Haddley/bikespeed/rearlight/fuse_block_side_exit.3mf

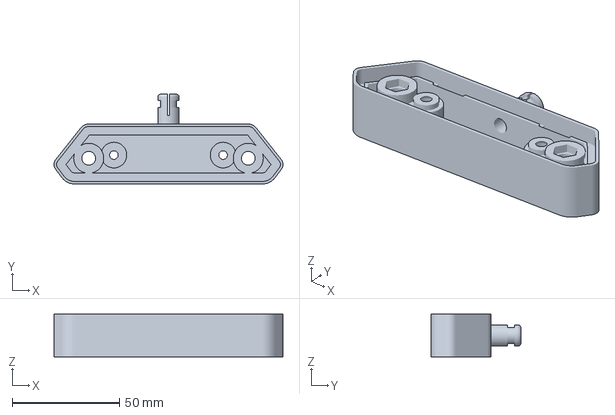
[picture p1: CAD file, 2026-10-20]
rearlight/fuse_block_side_exit.3mf
106.9 x 42.0 x 20.0 mm
