Haddley/bikespeed/rearlight/fuse_block.3mf

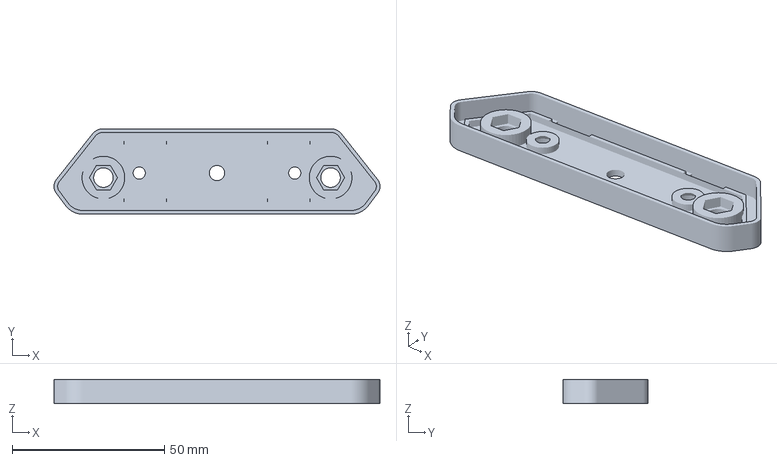
[picture p2: CAD file, 2026-10-19]
rearlight/fuse_block.3mf
106.9 x 28.0 x 8.00 mm
