Haddley/bikespeed/(list of files, cad)

Other CAD files:
rearlight/fuse_block.stl
rearlight/fuse_block_side_exit.stl
