Haddley/bikespeed/(commit log)

2026-10-19 Add rearlight fuse block half: parametric OpenSCAD model and STL
    Open tray with rim, gutter, stud/screw bosses, cable hole,
    side slots and four clip recesses.
    [fuse_block.scad, fuse_block.stl]
2026-10-19 include bike break
    [fuse_block.3mf, fuse_block.scad, fuse_block.stl]
2026-10-19 updated outline shape
    [fuse_block.3mf, fuse_block.scad, fuse_block.stl]
2026-10-19 another adjustment
    [fuse_block.scad, fuse_block.stl]
2026-10-19 another go
    [fuse_block.scad, fuse_block.stl]
2026-10-20 Add Design 2: fuse_block_side_exit, with a side cable exit and clamp
    A variant of fuse_block with no cable hole through the floor. The tray is 12 mm
    deeper so the cable can turn inside it and leave through the edge wall, held by
    a slit clamp with a zip tie groove. Everything the mating part touches is
    measured from the open face, so it sees the same tray as fuse_block. With
    extra_depth = 0 and cable_exit = false the file exports an STL identical to
    fuse_block.stl. Includes the STL and the Bambu Studio project.
    [fuse_block_side_exit.3mf, fuse_block_side_exit.scad, fuse_block_side_exit.stl]
2026-10-31 HUBSPEED RELEASE VERSION 1.0
    Released working version of the hubspeed firmware: brake-line cut-out above
    25 km/h (release below 24 km/h) with the pin-change noise filter, 678 bytes.
    Adds build_and_flash.sh, the brake_test sketch, updated breadboard and circuit
    diagrams, design notes and CLAUDE.md.
    [brake_test.cpp, brake_test.ino, hubspeed.ino]
